blueteef/PTZ_controller/visual_reference/Screenshot 2026-04-22 175219.png

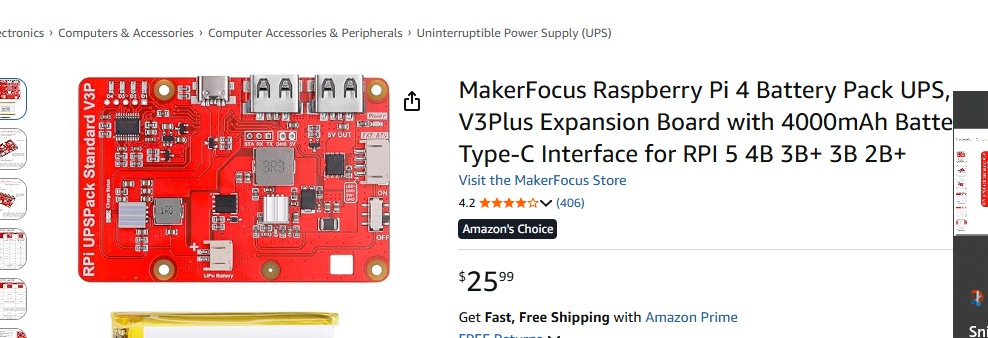
visual_reference/Screenshot 2026-04-22 175219.png
