blueteef/PTZ_controller/visual_reference/reference object.jpg

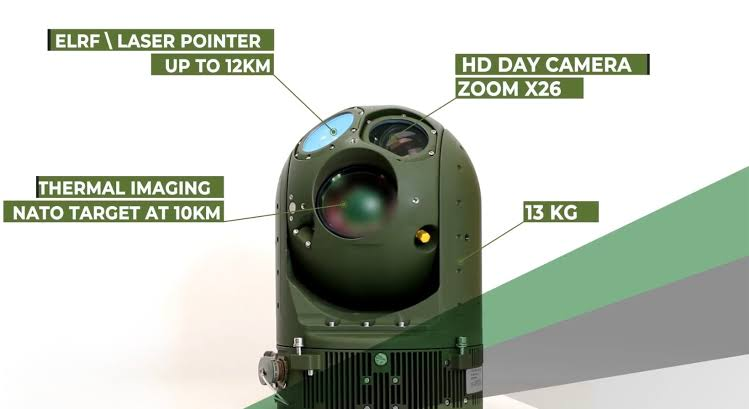
visual_reference/reference object.jpg
