blueteef/PTZ_controller/visual_reference/can_spi_mod_schematic.png

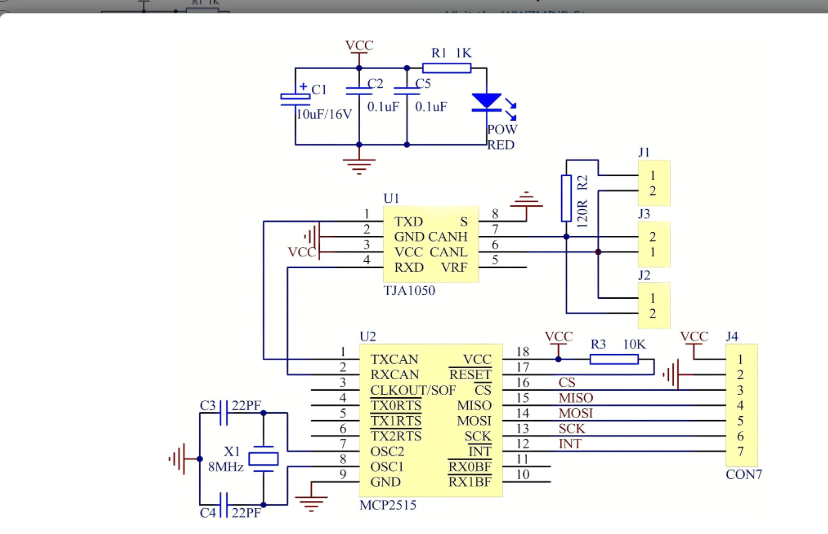
visual_reference/can_spi_mod_schematic.png
