blueteef/PTZ_controller/visual_reference/can_trans.png

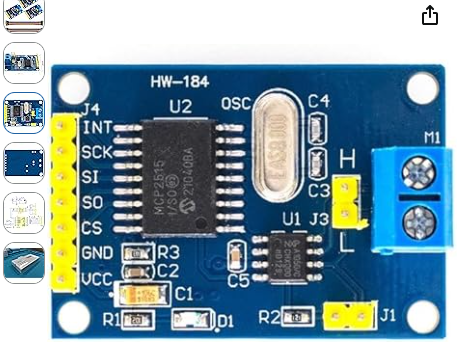
visual_reference/can_trans.png
