blueteef/PTZ_controller/visual_reference/full_schematic.jpg

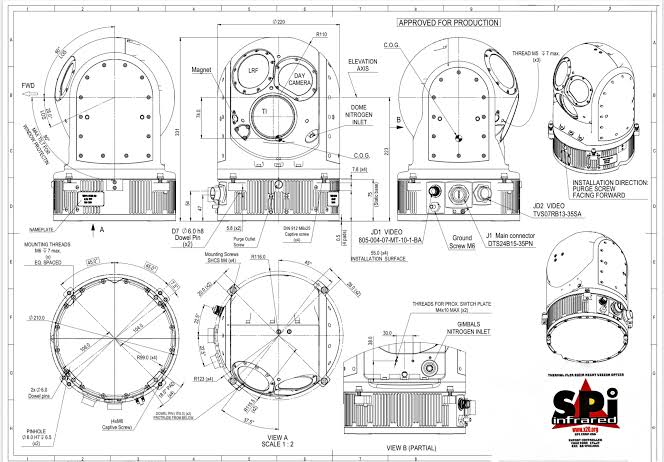
visual_reference/full_schematic.jpg
