blueteef/PTZ_controller/visual_reference/mcp_trans_actual.png

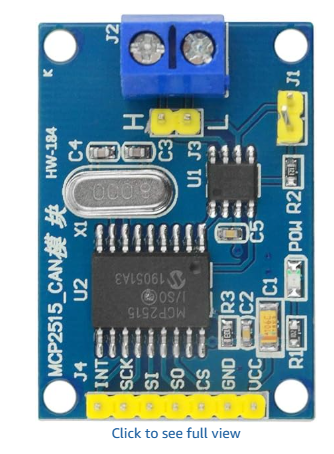
visual_reference/mcp_trans_actual.png
