blueteef/PTZ_controller/visual_reference/waveshare_can_1.png

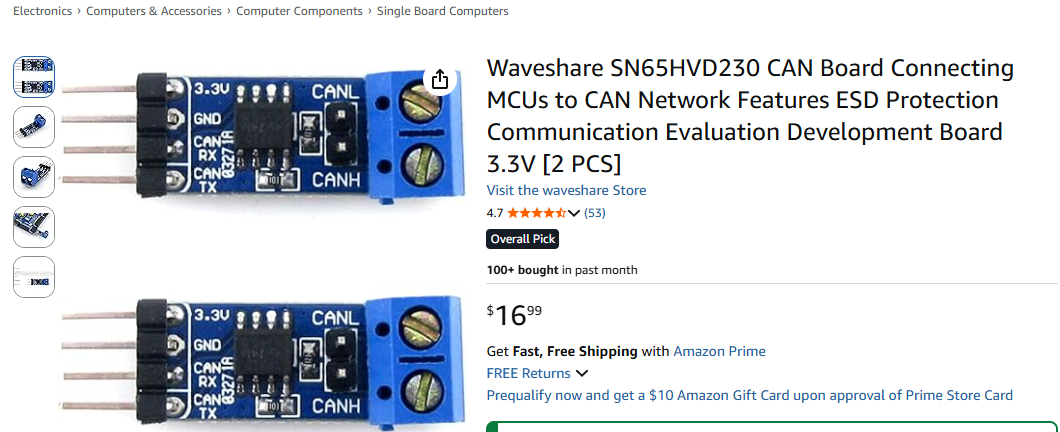
visual_reference/waveshare_can_1.png
