blueteef/PTZ_controller/Cbuild_log.txt

/usr/bin/bash: line 1: pio: command not found
