blueteef/PTZ_controller/KiCAD Models/EOIR_gimbal/EOIR_gimbal.kicad_pcb

## KiCad design main_controller/main_controller.kicad_sch

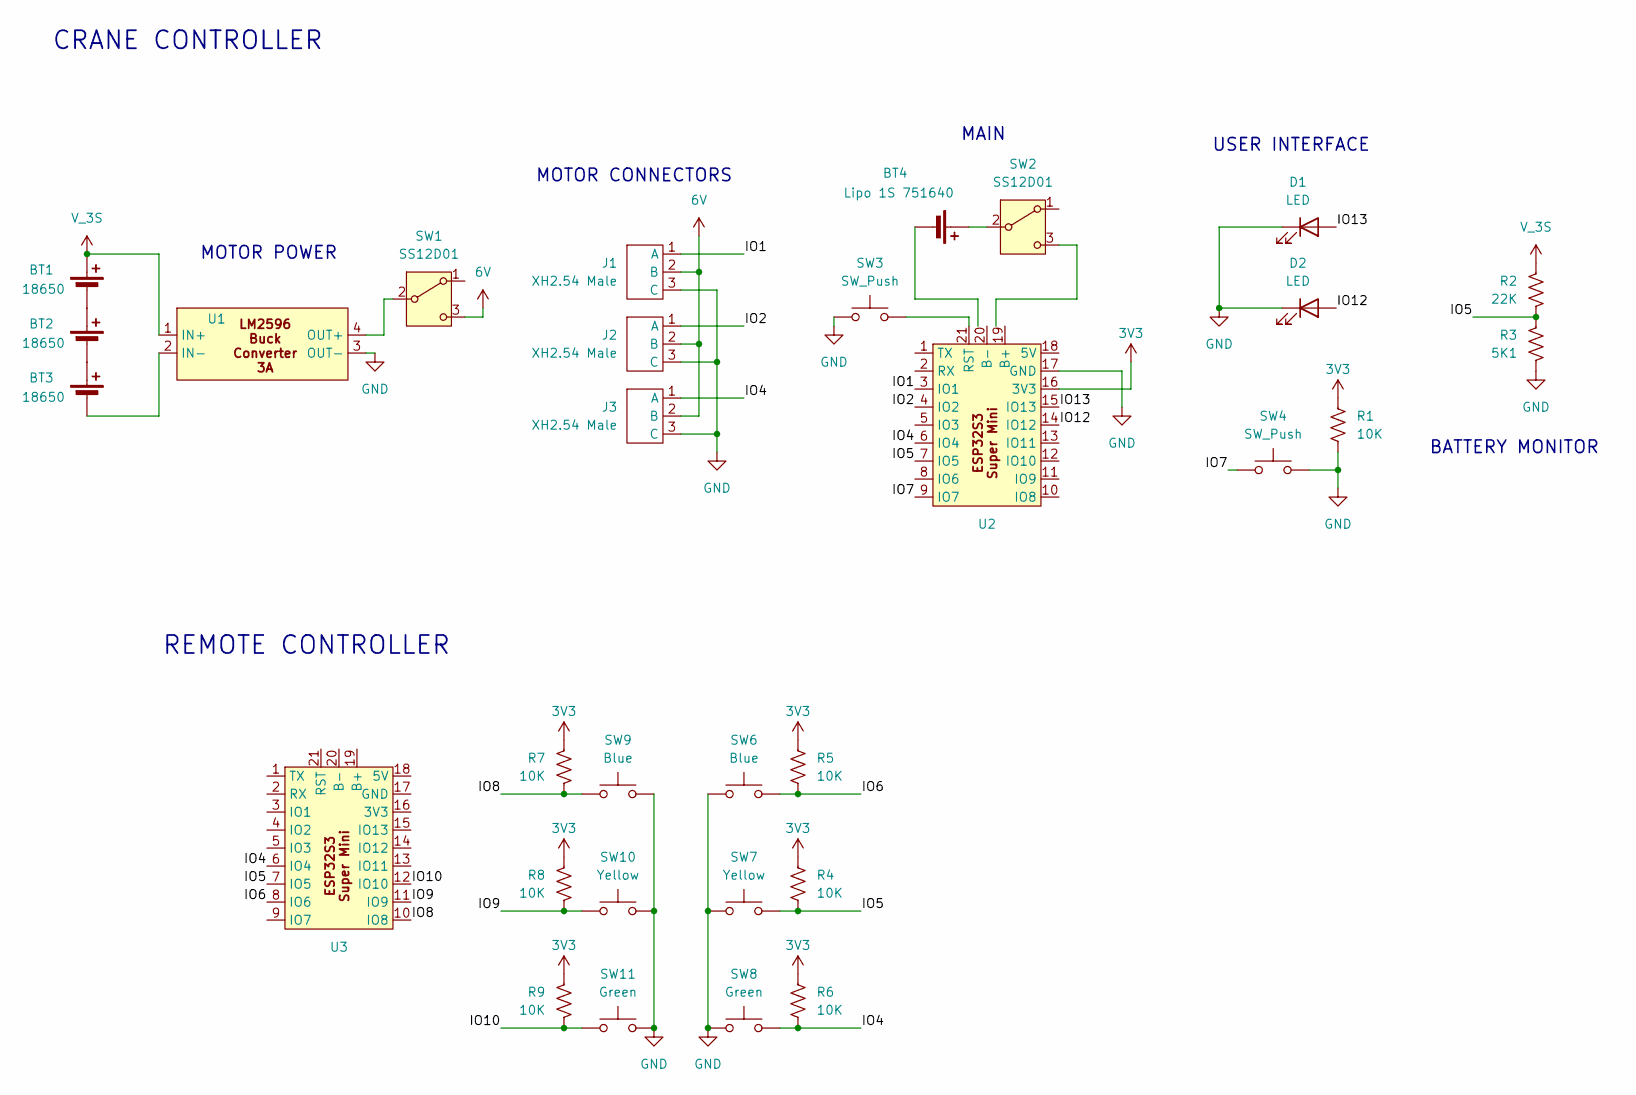
[picture p8: schematic main_controller.kicad_sch]

Parts:
BT1, BT2, BT3: 18650
BT4: Lipo 1S 751640
D1, D2: LED
J1, J2, J3: XH2.54 Male; XH_2p54_3P_male
R1, R4, R5, R6, R7, R8, R9: 10K
R2: 22K
R3: 5K1
SW1, SW2: SS12D01
SW3, SW4: SW_Push
SW6, SW9: Blue
SW7, SW10: Yellow
SW8, SW11: Green
U1: LM2596_Module
U2, U3: esp32s3_super_mini

Connections:
3V3: R1.1, R4.1, R5.1, R6.1, R7.1, R8.1, R9.1, U2.16 (3V3)
6V: J1.2 (B), J2.2 (B), J3.2 (B), SW1.3 (C)
GND: D1.1 (K), D2.1 (K), J1.3 (C), J2.3 (C), J3.3 (C), R1.2, R3.2, SW3.1, SW4.1, SW6.1, SW7.1, SW8.1, SW9.1, SW10.1, SW11.1, U1.3 (OUT-), U2.17 (GND)
IO1: J1.1 (A), U2.3 (IO1)
IO2: J2.1 (A), U2.4 (IO2)
IO4: J3.1 (A), R6.2, SW8.2, U2.6 (IO4), U3.6 (IO4)
IO5: R2.2, R3.1, R4.2, SW7.2, U2.7 (IO5), U3.7 (IO5)
IO6: R5.2, SW6.2, U3.8 (IO6)
IO7: SW4.2, U2.9 (IO7)
IO8: R7.2, SW9.2, U3.10 (IO8)
IO9: R8.2, SW10.2, U3.11 (IO9)
IO10: R9.2, SW11.2, U3.12 (IO10)
IO12: D2.2 (A), U2.14 (IO12)
IO13: D1.2 (A), U2.15 (IO13)
unnamed: BT1.2 (-), BT2.1 (+)
unnamed: BT2.2 (-), BT3.1 (+)
unnamed: BT3.2 (-), U1.2 (IN-)
unnamed: BT4.1 (+), SW2.2 (B)
unnamed: SW1.2 (B), U1.4 (OUT+)
unnamed: SW3.2, U2.21 (RST)
V_3S: BT1.1 (+), R2.1, U1.1 (IN+)

Notes on the sheet:
REMOTE CONTROLLER
CRANE CONTROLLER
MOTOR CONNECTORS
MAIN
BATTERY MONITOR
USER INTERFACE
MOTOR POWER
