blueteef/PTZ_controller/pi/app/main.py

"""
main.py — FastAPI application factory and lifespan.

Startup order:
  1. ESPBridge threads start (serial connection to ESP32)
  2. CameraCapture thread starts
  3. VisionPipeline thread starts
  4. GimbalTracker initialised (injected with bridge.send)
  5. FastAPI serves routes

Shutdown: threads stopped in reverse order.

Launch:
  cd pi/
  uvicorn app.main:app --host 0.0.0.0 --port 8000

For development (auto-reload, Pi not required):
  uvicorn app.main:app --reload
"""

from __future__ import annotations

import asyncio
import logging
import signal
import sys
from contextlib import asynccontextmanager
from pathlib import Path

from fastapi import FastAPI
from fastapi.staticfiles import StaticFiles

from app.serial_bridge.bridge import bridge
from app.can.bridge import start as can_start, stop as can_stop
from app.can.protocol import build_home_cmd, AXIS_ALL
from app.can.bridge import send as can_send
from app.imu.reader import imu_reader
from app.camera.capture import camera
from app.camera.thermal import thermal_camera
from app.camera.webcam import webcam
from app.ups.reader import ups_reader
from app.vision.pipeline import pipeline
import app.vision.tracker as tracker_module
from app.vision.tracker import GimbalTracker
from app.api import router_stream, router_control, router_detection, router_settings, router_faces
from app.api import router_thermal
from app.api import router_webcam
from app import db

logging.basicConfig(
    level=logging.INFO,
    format="%(asctime)s  %(levelname)-8s  %(name)s  %(message)s",
)
log = logging.getLogger(__name__)

# Ensure Ctrl+C and systemctl stop both work cleanly
signal.signal(signal.SIGINT,  lambda *_: sys.exit(0))
signal.signal(signal.SIGTERM, lambda *_: sys.exit(0))


@asynccontextmanager
async def lifespan(app: FastAPI):
    # ── Startup ────────────────────────────────────────────────────────
    log.info("PTZ Pi server starting up")

    db.init_db()
    bridge.start()
    can_start()
    imu_reader.start()
    camera.start()
    thermal_camera.start()
    webcam.start()
    ups_reader.start()
    pipeline.start()

    # Inject bridge into tracker
    tracker_module.tracker = GimbalTracker(send_fn=bridge.send)

    # Auto-home disabled — trigger manually via Home All button in sidebar
    # (motor PWM causes CAN noise; home only when system is confirmed stable)

    log.info("All subsystems started")
    yield

    # ── Shutdown ───────────────────────────────────────────────────────
    log.info("Shutting down")
    if tracker_module.tracker:
        tracker_module.tracker.stop()
    pipeline.stop()
    camera.stop()
    thermal_camera.stop()
    webcam.stop()
    ups_reader.stop()
    imu_reader.stop()
    can_stop()
    bridge.stop()
    log.info("Shutdown complete")


app = FastAPI(
    title="PTZ Controller",
    description="Raspberry Pi vision and control server for the PTZ gimbal",
    version="2.0.0",
    lifespan=lifespan,
)

# ── Routers ────────────────────────────────────────────────────────────────
app.include_router(router_stream.router)
app.include_router(router_control.router)
app.include_router(router_detection.router)
app.include_router(router_settings.router)
app.include_router(router_faces.router)
app.include_router(router_thermal.router)
app.include_router(router_webcam.router)

# ── Static files (frontend) ────────────────────────────────────────────────
_frontend = Path(__file__).parent / "frontend"
app.mount("/", StaticFiles(directory=str(_frontend), html=True), name="frontend")
