blueteef/PTZ_controller/pi/app/config.py

"""
config.py — All tuneable constants for the Pi application.

Values can be overridden via environment variables or a .env file.
Load order: defaults below → .env file → environment.
"""

import os
from pathlib import Path

# Load .env file if present (must happen before any os.getenv calls)
try:
    from dotenv import load_dotenv
    load_dotenv(Path(__file__).parent.parent / ".env", override=True)
except ImportError:
    pass


def _env_bool(key: str, default: str = "false") -> bool:
    """Read a boolean env var robustly — strips whitespace, case-insensitive."""
    return os.getenv(key, default).strip().lower() == "true"

# ---------------------------------------------------------------------------
# Paths
# ---------------------------------------------------------------------------
PI_DIR   = Path(__file__).parent.parent          # pi/
DATA_DIR = PI_DIR / "data"
MODEL_DIR = PI_DIR / "models"

DATA_DIR.mkdir(exist_ok=True)
MODEL_DIR.mkdir(exist_ok=True)

DB_PATH              = str(DATA_DIR / "faces.db")
MODEL_YOLO_PATH      = str(MODEL_DIR / "yolov8n.pt")
MODEL_OBJECT_PATH    = str(MODEL_DIR / "efficientdet_lite0_int8.tflite")

# ---------------------------------------------------------------------------
# ESP32 serial bridge (v1 / fallback)
# ---------------------------------------------------------------------------
SERIAL_PORT        = os.getenv("SERIAL_PORT", "/dev/serial0")
SERIAL_BAUD        = int(os.getenv("SERIAL_BAUD", "115200"))
SERIAL_TIMEOUT     = 0.1   # seconds — read timeout per call
SERIAL_RECONNECT_S = 2.0   # wait between reconnect attempts

# ---------------------------------------------------------------------------
# CAN bus (v2 hardware — python-can socketcan)
# ---------------------------------------------------------------------------
CAN_CHANNEL = os.getenv("CAN_CHANNEL", "can0")
CAN_BITRATE = int(os.getenv("CAN_BITRATE", "500000"))

# ---------------------------------------------------------------------------
# Camera
# ---------------------------------------------------------------------------
# CAMERA_BACKEND: "picamera2" = CSI camera via libcamera (IMX462, IMX708, etc.)
#                 "v4l2"      = USB webcam via OpenCV V4L2 (current setup)
#                 "auto"      = try picamera2 first, fall back to v4l2
CAMERA_BACKEND = os.getenv("CAMERA_BACKEND", "v4l2")
CAMERA_DEVICE  = os.getenv("CAMERA_DEVICE",  "/dev/video0")   # V4L2 only
CAMERA_NUM     = int(os.getenv("CAMERA_NUM", "0"))             # Picamera2 camera index

CAMERA_WIDTH   = int(os.getenv("CAMERA_WIDTH",  "1280"))
CAMERA_HEIGHT  = int(os.getenv("CAMERA_HEIGHT", "720"))
CAMERA_FPS     = int(os.getenv("CAMERA_FPS",    "30"))

# IMX708 (Arducam/Pi Camera Module 3) field of view.
# Full-sensor binned mode (~66°H x 41°V) — applies at all output resolutions.
# Tune empirically by pointing at a target at known angles.
CAMERA_FOV_H_DEG = 66.0   # horizontal degrees
CAMERA_FOV_V_DEG = 41.0   # vertical degrees

# Camera orientation correction — set based on physical mount.
# 0=none, 1=90°CW, 2=180°(upside-down), 3=90°CCW
CAMERA_ROTATION = int(os.getenv("CAMERA_ROTATION", "0"))

# Image quality tuning.
# Sharpness 0-16 (default 1.0): higher = crisper edges, helps detection.
# Contrast  0-32 (default 1.0): slight boost separates features.
# NoiseReductionMode: 0=off 1=fast 2=high-quality
# AwbMode: 0=auto 1=incandescent 2=tungsten 3=fluorescent 4=indoor 5=daylight 6=cloudy
# AeMeteringMode: 0=centre-weighted 1=spot 2=matrix
CAMERA_SHARPNESS          = float(os.getenv("CAMERA_SHARPNESS",    "1.5"))
CAMERA_CONTRAST           = float(os.getenv("CAMERA_CONTRAST",     "1.1"))
CAMERA_NOISE_REDUCTION    = int(os.getenv("CAMERA_NOISE_REDUCTION", "1"))
CAMERA_AWB_MODE           = int(os.getenv("CAMERA_AWB_MODE",        "0"))
CAMERA_AE_METERING_MODE   = int(os.getenv("CAMERA_AE_METERING_MODE","0"))

# Autofocus — IMX708 only (Camera Module 3 / Arducam 12MP AF).
# AfMode: 0=manual  1=auto (trigger on demand)  2=continuous
# AfSpeed: 0=normal  1=fast
# AfRange: 0=normal (0.1m–inf)  1=macro  2=full
CAMERA_AF_MODE  = int(os.getenv("CAMERA_AF_MODE",  "2"))   # continuous
CAMERA_AF_SPEED = int(os.getenv("CAMERA_AF_SPEED", "1"))   # fast
CAMERA_AF_RANGE = int(os.getenv("CAMERA_AF_RANGE", "0"))   # normal

# ---------------------------------------------------------------------------
# MJPEG stream
# ---------------------------------------------------------------------------
MJPEG_QUALITY      = int(os.getenv("MJPEG_QUALITY", "75"))
MJPEG_TARGET_FPS   = CAMERA_FPS   # stream pacing

# ---------------------------------------------------------------------------
# UPS (MakerFocus UPSPack V3P — UART stream + STA shutdown pin)
# ---------------------------------------------------------------------------
# Requires in /boot/firmware/config.txt:
#   enable_uart=1
#   dtoverlay=disable-bt
# UPS_PORT: serial device (default /dev/ttyAMA0), or "none" to disable
# UPS_STA_GPIO: BCM GPIO for the STA shutdown signal pin (default 4 = physical pin 7)
UPS_PORT     = os.getenv("UPS_PORT",     "/dev/ttyAMA0")
UPS_STA_GPIO = int(os.getenv("UPS_STA_GPIO", "4"))

# ---------------------------------------------------------------------------
# Webcam (secondary visible camera — USB UVC, not the TC001 thermal)
# ---------------------------------------------------------------------------
# WEBCAM_DEVICE: "auto" = scan /dev/video0–19, skip TC001 and Pi camera devices
#                "/dev/videoX" = use specific device
#                "none" = disable
WEBCAM_DEVICE  = os.getenv("WEBCAM_DEVICE",  "auto")
WEBCAM_WIDTH   = int(os.getenv("WEBCAM_WIDTH",  "1280"))
WEBCAM_HEIGHT  = int(os.getenv("WEBCAM_HEIGHT", "720"))
WEBCAM_FPS     = int(os.getenv("WEBCAM_FPS",    "30"))

# ---------------------------------------------------------------------------
# Thermal camera (Topdon TC002 or compatible UVC thermal imager)
# ---------------------------------------------------------------------------
# THERMAL_DEVICE: "auto" = scan /dev/video0–19 for the first working device,
#                 "/dev/videoX" = use a specific device,
#                 "none" = disable thermal camera entirely.
THERMAL_DEVICE   = os.getenv("THERMAL_DEVICE", "auto")
# THERMAL_COLORMAP: OpenCV colormap name (INFERNO, JET, HOT, RAINBOW, etc.)
THERMAL_COLORMAP = os.getenv("THERMAL_COLORMAP", "INFERNO")

# ---------------------------------------------------------------------------
# Vision / detection
# ---------------------------------------------------------------------------
YOLO_CONFIDENCE    = float(os.getenv("YOLO_CONFIDENCE", "0.45"))
FACE_MIN_CONFIDENCE  = float(os.getenv("FACE_MIN_CONFIDENCE", "0.4"))  # MediaPipe threshold
FACE_MODEL_SELECTION = int(os.getenv("FACE_MODEL_SELECTION", "1"))     # 0=short range (<2m), 1=full range

# Detection performance — reduce CPU load on Pi
# DET_SCALE:      resize frame before object detection (YOLO/EfficientDet).  0.5 = half res.
#                 Bounding boxes are automatically scaled back to full resolution.
# FACE_DET_SCALE: scale for face detection.  MediaPipe face detection is fast enough at full
#                 resolution and is much more accurate — keep at 1.0 unless CPU is overloaded.
# DET_SKIP:       only run detector every N frames; reuse previous boxes in between.
DET_SCALE      = float(os.getenv("DET_SCALE",      "0.5"))
FACE_DET_SCALE = float(os.getenv("FACE_DET_SCALE", "1.0"))
DET_SKIP       = int(os.getenv("DET_SKIP",         "2"))

# ---------------------------------------------------------------------------
# Face recognition
# ---------------------------------------------------------------------------
FACE_RECOGNITION_TOLERANCE = float(os.getenv("FACE_RECOGNITION_TOLERANCE", "0.5"))
FACE_ENROLL_FRAMES         = 5   # frames captured per enrollment session

# ---------------------------------------------------------------------------
# Motion settings — Pi is the single source of truth.
# These are pushed to the ESP32 on every connect via push_settings().
# Changing them here (or via .env) is the only place you need to edit.
# ---------------------------------------------------------------------------
MAX_SPEED_DEG_S     = float(os.getenv("MAX_SPEED_DEG_S",     "180.0"))  # slider hard cap
DEFAULT_SPEED_DEG_S = float(os.getenv("DEFAULT_SPEED_DEG_S",  "45.0"))   # slider start value
ACCEL_DEG_S2     = float(os.getenv("ACCEL_DEG_S2",    "120.0"))
FINE_SPEED_SCALE = float(os.getenv("FINE_SPEED_SCALE",  "0.2"))

# Axis direction invert — flips the DIR pin on the ESP32 A4988 driver.
# Set in .env: PAN_INVERT=true  or  TILT_INVERT=true
PAN_INVERT  = _env_bool("PAN_INVERT")
TILT_INVERT = _env_bool("TILT_INVERT")

# Soft limits (degrees at output shaft)
PAN_SOFT_LIMIT_MIN  = float(os.getenv("PAN_SOFT_LIMIT_MIN",  "-180.0"))
PAN_SOFT_LIMIT_MAX  = float(os.getenv("PAN_SOFT_LIMIT_MAX",   "180.0"))
TILT_SOFT_LIMIT_MIN = float(os.getenv("TILT_SOFT_LIMIT_MIN",  "-45.0"))
TILT_SOFT_LIMIT_MAX = float(os.getenv("TILT_SOFT_LIMIT_MAX",   "90.0"))
SOFT_LIMITS_ENABLED = _env_bool("SOFT_LIMITS_ENABLED")

# How long to hold stepper current after motors stop (ms). 0 = hold forever.
# A4988 has no current-reduction mode — releasing EN eliminates heat and whine.
STEPPER_HOLD_MS = int(os.getenv("STEPPER_HOLD_MS", "2000"))

# ---------------------------------------------------------------------------
# IMU / Compass orientation alignment
# Correct for physical sensor mounting without reflashing the ESP32.
# ---------------------------------------------------------------------------

# Sign correction: 1 = normal, -1 = flip axis
IMU_ROLL_SIGN  = float(os.getenv("IMU_ROLL_SIGN",  "1"))
IMU_PITCH_SIGN = float(os.getenv("IMU_PITCH_SIGN", "1"))

# Swap roll and pitch if sensor is mounted 90° rotated around Z
IMU_SWAP_ROLL_PITCH = _env_bool("IMU_SWAP_ROLL_PITCH", "false")

# Zero-point offset (degrees) — applied after sign/swap correction.
# Use to remove a constant bias when the camera is level.
# e.g. if pitch reads +90° when level: IMU_PITCH_OFFSET_DEG=-90
IMU_ROLL_OFFSET_DEG  = float(os.getenv("IMU_ROLL_OFFSET_DEG",  "0.0"))
IMU_PITCH_OFFSET_DEG = float(os.getenv("IMU_PITCH_OFFSET_DEG", "0.0"))

# Compass offset (degrees) — corrects for magnetic declination or physical mount offset.
# Add your local declination (positive = east) or physical rotation here.
MAG_HDG_OFFSET_DEG = float(os.getenv("MAG_HDG_OFFSET_DEG", "0.0"))

# Invert compass direction (true = flip N/S, useful if sensor mounted backwards)
MAG_HDG_INVERT = _env_bool("MAG_HDG_INVERT", "false")

# ---------------------------------------------------------------------------
# IMU — tilt end-effector MPU-6050 (Pi I2C bus, GPIO 2/3)
#
# This is the TILT-CENTRIC IMU — mounted at the camera/end-effector for fine
# camera stabilization and acceleration compensation.
#
# The VEHICLE/PLATFORM IMU is a separate MPU-6050 on the stationary ESP32
# I2C bus. It reports vehicle attitude to the CAN bus as MSG_SENSOR_IMU and
# is used to correct for gross platform motion. These two sensors serve
# independent roles and are read by different nodes.
# ---------------------------------------------------------------------------
IMU_I2C_BUS   = int(os.getenv("IMU_I2C_BUS",   "1"))     # i2c-1: GPIO 2/3
IMU_RATE_HZ   = int(os.getenv("IMU_RATE_HZ",   "50"))    # complementary filter rate
IMU_COMP_ALPHA = float(os.getenv("IMU_COMP_ALPHA", "0.95"))  # gyro/accel blend

# Apply tilt compensation to compass using IMU roll/pitch.
# Set false if compass is mounted on the pan axis (doesn't tilt with camera)
# or if the IMU and compass are on different axes.
MAG_TILT_COMPENSATE = _env_bool("MAG_TILT_COMPENSATE", "true")

# ---------------------------------------------------------------------------
# Tracking PID
# ---------------------------------------------------------------------------
PID_KP             = 2.0     # proportional gain  (error in degrees → deg/s)
PID_KI             = 0.01    # integral gain
PID_KD             = 0.05    # derivative gain
PID_MAX_VEL_DEG_S  = float(os.getenv("PID_MAX_VEL_DEG_S", "45.0"))  # tracking speed cap
TRACKING_DEADBAND_PX = 15    # pixel radius around center — no correction inside

# Coast mode: if no detection for this many frames, decay velocity to zero
TRACKING_COAST_FRAMES = 5

# ---------------------------------------------------------------------------
# Telemetry
# ---------------------------------------------------------------------------
TELEMETRY_INTERVAL_S = 0.1   # how often to push telemetry to WebSocket clients

# ---------------------------------------------------------------------------
# Web server
# ---------------------------------------------------------------------------
HOST = "0.0.0.0"
PORT = 8000

# ---------------------------------------------------------------------------
# Claude API (optional)
# ---------------------------------------------------------------------------
ANTHROPIC_API_KEY = os.getenv("ANTHROPIC_API_KEY", "")
CLAUDE_MODEL      = "claude-haiku-4-5-20251001"
