blueteef/PTZ_controller/src/sensors/SensorManager.cpp

// =============================================================================
// SensorManager.cpp
// =============================================================================

#include "SensorManager.h"
#include <Wire.h>
#include <SoftwareSerial.h>
#include <INA226_WE.h>
#include <Adafruit_BMP280.h>
#include <TinyGPSPlus.h>
#include <math.h>
#include "config.h"

// I2C0 — stationary side
static INA226_WE       _ina(INA226_I2C_ADDR);
static Adafruit_BMP280 _bmp;

// GPS on SoftwareSerial — HardwareSerial 1 reserved for TMC2209 UART
static TinyGPSPlus     _gps;
static SoftwareSerial  _gpsSerial;

// -----------------------------------------------------------------------------
// Public
// -----------------------------------------------------------------------------

bool SensorManager::begin() {
    // I2C bus 0 — shared by INA226 and BMP280
    Wire.begin(I2C0_SDA_PIN, I2C0_SCL_PIN);

    // INA226
    _inaOk = _ina.init();
    if (_inaOk) {
        _ina.setResistorRange(INA226_SHUNT_OHM, INA226_MAX_A);
        Serial.printf("[SENS] INA226 OK — shunt %.3f Ω, max %.1f A\r\n",
                      INA226_SHUNT_OHM, INA226_MAX_A);
    } else {
        Serial.println("[SENS] INA226 not found (check I2C wiring/address)");
    }
    _data.inaOk = _inaOk;

    // BMP280
    _bmpOk = _bmp.begin(BMP280_I2C_ADDR);
    if (_bmpOk) {
        // Normal mode: 2x temp / 16x pressure oversampling, 16x IIR filter, 500 ms standby
        _bmp.setSampling(Adafruit_BMP280::MODE_NORMAL,
                         Adafruit_BMP280::SAMPLING_X2,
                         Adafruit_BMP280::SAMPLING_X16,
                         Adafruit_BMP280::FILTER_X16,
                         Adafruit_BMP280::STANDBY_MS_500);
        Serial.printf("[SENS] BMP280 OK (0x%02X)\r\n", BMP280_I2C_ADDR);
    } else {
        Serial.println("[SENS] BMP280 not found (check SDO pin, try addr 0x77)");
    }
    _data.bmpOk = _bmpOk;

    // GPS on SoftwareSerial — HardwareSerial 1 (Serial1) is reserved for TMC2209 UART
    _gpsSerial.begin(GPS_BAUD_RATE, SWSERIAL_8N1, GPS_RX_PIN, GPS_TX_PIN);
    Serial.printf("[SENS] GPS SoftwareSerial started — GPIO%d RX, GPIO%d TX, %d baud\r\n",
                  GPS_RX_PIN, GPS_TX_PIN, GPS_BAUD_RATE);

    // QMC5883L — direct Wire register access (I2C0, stationary side)
    // IMU (MPU-6050) is now read directly by the Pi on its own I2C bus.
    Wire.beginTransmission(QMC5883L_I2C_ADDR);
    Wire.write(0x0B);  // SET/RESET period register — must be 0x01 per datasheet
    Wire.write(0x01);
    _magOk = (Wire.endTransmission() == 0);
    if (_magOk) {
        Wire.beginTransmission(QMC5883L_I2C_ADDR);
        Wire.write(0x09);  // Control Register 1
        Wire.write(0x1D);  // Continuous mode | 200 Hz | 8G range | 512 OSR
        Wire.endTransmission();
        Serial.printf("[SENS] QMC5883L OK (0x%02X)\r\n", QMC5883L_I2C_ADDR);
    } else {
        Serial.println("[SENS] QMC5883L not found (check I2C0 wiring)");
    }
    _data.magOk = _magOk;

    return true;
}

// -----------------------------------------------------------------------------
// Private — called from sensorTask
// -----------------------------------------------------------------------------

void SensorManager::_readINA() {
    if (!_inaOk) return;
    _ina.readAndClearFlags();   // required before reading — clears conversion-ready flag
    _data.busVoltageV = _ina.getBusVoltage_V();
    _data.currentMA   = _ina.getCurrent_mA();
    _data.powerMW     = _ina.getBusPower() * 1000.0f;  // getBusPower() returns W → mW
}

void SensorManager::_readBMP() {
    if (!_bmpOk) return;
    _data.tempC    = _bmp.readTemperature();
    _data.pressHPa = _bmp.readPressure() / 100.0f;
    _data.altM     = _bmp.readAltitude(1013.25f);  // standard sea-level reference
}

void SensorManager::_feedGPS() {
    while (_gpsSerial.available()) {
        _gps.encode(_gpsSerial.read());
    }
    _data.gpsFix  = _gps.location.isValid();
    _data.gpsSats = _gps.satellites.isValid() ? (uint8_t)_gps.satellites.value() : 0;
    if (_gps.location.isValid()) {
        _data.gpsLat = _gps.location.lat();
        _data.gpsLon = _gps.location.lng();
    }
    _data.gpsHdgDeg   = _gps.course.isValid() ? (float)_gps.course.deg()  : 0.0f;
    _data.gpsSpdKnots = _gps.speed.isValid()  ? (float)_gps.speed.knots() : 0.0f;
}

void SensorManager::_readMag() {
    if (!_magOk) return;
    Wire.beginTransmission(QMC5883L_I2C_ADDR);
    Wire.write(0x00);  // data registers start at 0x00
    if (Wire.endTransmission(false) != 0) return;
    Wire.requestFrom((uint8_t)QMC5883L_I2C_ADDR, (uint8_t)6);
    if (Wire.available() < 6) return;
    // Store raw counts — tilt compensation is done on the Pi using
    // corrected roll/pitch so the IMU axis orientation offsets are applied.
    _data.magRawX = (int16_t)(Wire.read() | (Wire.read() << 8));
    _data.magRawY = (int16_t)(Wire.read() | (Wire.read() << 8));
    _data.magRawZ = (int16_t)(Wire.read() | (Wire.read() << 8));
    _data.magOk   = true;
}

void SensorManager::_pushSlow() {
    Serial2.printf("$PWR ok=%d,vin=%.3f,curr=%.1f,pwr=%.1f\r\n",
                   _data.inaOk ? 1 : 0,
                   _data.busVoltageV, _data.currentMA, _data.powerMW);
    if (_data.bmpOk) {
        Serial2.printf("$ENV temp=%.2f,press=%.2f,alt=%.1f\r\n",
                       _data.tempC, _data.pressHPa, _data.altM);
    }
    Serial2.printf("$GPS lat=%.6f,lon=%.6f,fix=%d,sats=%d,hdg=%.1f,spd=%.2f\r\n",
                   _data.gpsLat, _data.gpsLon,
                   _data.gpsFix ? 1 : 0,
                   _data.gpsSats,
                   _data.gpsHdgDeg,
                   _data.gpsSpdKnots);
}

void SensorManager::_pushFast() {
    Serial2.printf("$MAG ok=%d,mx=%d,my=%d,mz=%d\r\n",
                   _data.magOk ? 1 : 0,
                   _data.magRawX, _data.magRawY, _data.magRawZ);
}

// -----------------------------------------------------------------------------
// FreeRTOS task
// -----------------------------------------------------------------------------

void SensorManager::sensorTask(void* param) {
    SensorManager* sm = static_cast<SensorManager*>(param);

    for (;;) {
        uint32_t now = millis();

        // Compass: read and push at 20 Hz
        if (now - sm->_lastImuPushMs >= SENSOR_IMU_PUSH_MS) {
            sm->_lastImuPushMs = now;
            sm->_readMag();
            sm->_pushFast();
        }

        // GPS feed: run every task tick for fast fix acquisition
        sm->_feedGPS();

        // Slow sensors: INA226 / BMP280 / GPS telemetry at 1 Hz
        if (now - sm->_lastSlowMs >= SENSOR_PUSH_MS) {
            sm->_lastSlowMs = now;
            sm->_readINA();
            sm->_readBMP();
            sm->_pushSlow();
        }

        vTaskDelay(pdMS_TO_TICKS(10));  // 100 Hz task rate, handles 20 Hz IMU timing
    }
}
