blueteef/PTZ_controller/src/sensors/SensorManager.h

#pragma once

// =============================================================================
// SensorManager — Stationary and moving-side sensor suite.
//
// Stationary (I2C0, GPIO22/23):
//   INA226   — 12 V bus voltage, current, power (0x40, R100 shunt)
//   BMP280   — temperature, pressure, altitude   (0x76, SDO=GND)
//   GPS      — lat/lon/heading/speed/fix/sats    (SoftwareSerial GPIO16/13)
//   QMC5883L — compass raw counts (0x0D) — pan axis mount, away from motors/RF
//
// IMU (MPU-6050) now read directly by the Pi (end-effector mount, Pi I2C).
//
// Push protocol (Serial2 → Pi, 1 Hz):
//   $PWR ok=1,vin=12.45,curr=823.0,pwr=10234.0
//   $ENV temp=23.4,press=1013.2,alt=45.3
//   $GPS lat=47.123456,lon=-122.567890,fix=1,sats=8,hdg=180.5,spd=0.00
//   $MAG ok=1,mx=1234,my=-567,mz=890
// =============================================================================

#include <Arduino.h>

struct SensorData {
    // INA226
    float busVoltageV = 0.0f;
    float currentMA   = 0.0f;
    float powerMW     = 0.0f;
    bool  inaOk       = false;

    // BMP280
    float tempC    = 0.0f;
    float pressHPa = 0.0f;
    float altM     = 0.0f;
    bool  bmpOk    = false;

    // GPS
    bool    gpsFix      = false;
    uint8_t gpsSats     = 0;
    double  gpsLat      = 0.0;
    double  gpsLon      = 0.0;
    float   gpsHdgDeg   = 0.0f;
    float   gpsSpdKnots = 0.0f;

    // QMC5883L compass (stationary/pan-axis) — raw counts; Pi does tilt compensation
    int16_t magRawX = 0;
    int16_t magRawY = 0;
    int16_t magRawZ = 0;
    bool    magOk   = false;
};

class SensorManager {
public:
    bool begin();

    SensorData getData() const { return _data; }

    static void sensorTask(void* param);

private:
    void _readINA();
    void _readBMP();
    void _feedGPS();
    void _readMag();
    void _pushSlow();   // INA / BMP / GPS  — 1 Hz
    void _pushFast();   // MAG              — 20 Hz

    SensorData _data;
    bool     _inaOk         = false;
    bool     _bmpOk         = false;
    bool     _magOk         = false;
    uint32_t _lastSlowMs    = 0;   // INA / BMP / GPS push timer (1 Hz)
    uint32_t _lastImuPushMs = 0;   // MAG push timer (20 Hz)
};
