blueteef/PTZ_controller/(commit log)

2026-03-23 Add Phase 2 Pi application, vel CLI command, and project docs
    - src/cli: add `vel <pan|tilt|all> <deg_s>` command for continuous
    velocity control from Pi tracking loop (no echo/response printed)
    - pi/: full Phase 2 application scaffold (Phases 2a-2e complete)
    - FastAPI server: MJPEG stream, WebSocket control, detection API
    - Serial bridge to ESP32 via existing CLI protocol
    - Vision pipeline: null/face/YOLO detectors, PID tracker
    - Dark web UI: virtual joystick, WASD keys, detection overlay
    - Camera rotation config (CAMERA_ROTATION=2 for inverted mount)
    - Fix: stop/estop buttons now kill joystick velocity interval
    - docs/data_hx.txt: full session history and Phase 2 roadmap
    - .g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
    [CLI.cpp, CLI.h, bridge.py, capture.py, config.py]
2026-03-23 Fix controls: toggle/lag/focus issues
    - keydown/keyup moved to window (survives canvas focus steal)
    - ignore e.repeat on keydown (was firing continuous keydown events)
    - window blur clears all keys and stops motion immediately
    - joystick pointerup on window (survives drag outside canvas bounds)
    - send one velocity frame immediately on input (removes 40ms delay)
2026-03-23 Wire tracker into vision pipeline
    - Call tracker.update() after every detection pass when tracking enabled
    - Setting detection mode to 'none' now auto-stops tracking
2026-03-23 Improve joystick feel, add axis inversion config
    - Add PAN_INVERT / TILT_INVERT flags to config.py (env var overrideable)
    - Add JOYSTICK_DEFAULT_SPEED (default 45 deg/s, was 180 — much more manageable)
    - Squared response curve on joystick: precise at low deflection, full speed at max
    - Expose /api/settings/ui endpoint so frontend reads defaults from server config
    - Apply inversion in router_control.py velocity handler
    To invert an axis, set in pi/.env:
    PAN_INVERT=true
    TILT_INVERT=true
    [config.py]
2026-03-23 Fix stop: zero velocity before stop command for MKS CR_UART mode
    MKS drivers in CR_UART mode hold last velocity until new command arrives.
    Send vel=0 on both axes before stop/estop to ensure motion halts even if
    stop command is delayed or the driver misses it.
2026-03-23 Switch to stepper drive mode: direction invert flags, dotenv fix
    ESP32:
    - Add PAN_DIR_INVERT / TILT_DIR_INVERT to config.h
    - Apply direction invert in MotionController::begin() via setDirectionPin()
    Pi:
    - Add python-dotenv to requirements.txt
    - Load .env file in config.py so PAN_INVERT etc. actually take effect
    Next step: change MKS drivers to CR_vFOC mode via OLED, wire Step/Dir/EN,
    flash env:esp32dev_stepper
    [MotionController.cpp, config.h, config.py]
2026-03-23 Update session history: end of day 2026-03-22
    - Document stepper mode switch as the immediate next task
    - Update hardware status to reflect what was actually tested
    - Note YOLO ARM incompatibility, dotenv fix, camera rotation
    - Clear next-step instructions at top of session history
2026-03-23 Switch to stepper drive mode (CR_vFOC)
    - Reassign Step/Dir/EN pins: Pan=32/33/25, Tilt=26/27/14
    - Fix PTZ_VERSION_EXTRA string define escaping in platformio.ini
    - Guard software homing motor start with PTZ_DRIVE_STEPPER ifdef
    [MotionController.cpp, config.h]
2026-03-23 Update session log — session 4 end of day
    Tilt MKS driver dead (FET blowout), waiting on replacement.
    Notes: GPIO input-only pins, accel fix needed, pin assignments final.
2026-03-23 Add A4988 per-axis driver support
    New build envs: esp32dev_a4988_tilt, esp32dev_a4988_both.
    Per-axis flags TILT_DRIVER_A4988 / PAN_DRIVER_A4988 skip MKS UART
    driver instantiation for that axis (_driver[idx] stays nullptr).
    Null-guard all _driver[] call sites outside existing #ifdef blocks.
    Also fixes latent emergencyStop() nullptr crash in stepper builds.
    [CLI.cpp, MotionController.cpp]
2026-03-24 Refactor: A4988 drivers, WASD jog control, Pi UART link rather than USB
2026-03-24 Refactor: A4988 drivers, WASD jog control, Pi UART link rather than USB, fix UART
    [config.py]
2026-03-24 UART bridge to esp32 fixed
    [CLI.cpp, CLI.h, bridge.py]
2026-03-24 UART bridge to esp32 fixed again...
    [bridge.py, config.h]
2026-03-24 UART bridge to esp32 fixed again.....
    [config.h, main.cpp]
2026-03-24 UART bridge to esp32 fixed again........
    [config.h, config.py]
2026-03-25 Replace ultralytics/torch with onnxruntime for YOLO; fix PID gains, tracking invert, bridge lock contention
    [config.py, export_yolo_onnx.py]
2026-03-25 fix .env file example
    [capture.py, config.h, config.py]
2026-03-28 Allow Pi server to start without a physical camera
    Wrap Picamera2 init/start in try/except so a missing or failed camera
    falls back to blank frames instead of crashing the server.
    [capture.py]
2026-03-28 Swap pan/tilt GPIO pin assignments to match physical wiring
    [config.h]
2026-03-28 Add Arducam/IMX708 Camera Module 3 support with continuous autofocus
    - Update FOV to 66°H x 41°V for IMX708
    - Add AfMode/AfSpeed/AfRange controls (continuous AF by default)
    - Reset default rotation to 0 (IMX219 needed 180° flip)
    - Update .env.example with autofocus options
    [capture.py, config.py]
2026-03-28 Fix test_serial.py default port to /dev/serial0
    [test_serial.py]
2026-03-28 Add UART diagnostic script with hex dump and loopback check
2026-03-28 Fix CLI: add missing ping command, fix get responses on Serial2
    - ping was never in the dispatch table — Pi got no response
    - get speed/accel/limits only printed to USB, not Serial2
    - All query responses now go to both USB and Pi UART
    [CLI.cpp, CLI.h]
2026-03-28 Lower Pi UART baud rate to 57600 for slip ring reliability
2026-03-28 Add Serial2 boot message for UART diagnostics
2026-03-29 Add facial recognition, enrollment, and name-based tracking
    - db/__init__.py: SQLite face database (enroll, list, delete encodings)
    - detector_face.py: dlib recognition pass every 5 frames; assigns name to Detection
    - router_faces.py: REST endpoints GET/POST enroll/DELETE faces
    - pipeline.py: set_recognition() toggle; passes flag to FaceDetector
    - tracker.py: name-based target priority over ID-based
    - router_control.py: set_tracking accepts target_name; new set_recognition message
    - state.py: tracking_target_name, recognition_enabled fields
    - main.py: init DB on startup, register face router
    - Frontend: recognition toggle, enroll panel, track-by-name dropdown, enrolled faces list
    Requires o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
2026-03-29 Fix WASD unresponsive after face enrollment
    - Blur active element after enrollment so keyboard focus returns to page
    - Run face_encodings in thread pool executor to avoid blocking event loop
2026-03-29 Fix WASD blocked by select focus; fix Ctrl+C swallowed by dlib
    - controls.js: only block WASD on text inputs, not SELECT elements
    - main.py: install SIGINT handler so Ctrl+C always terminates the process
    [main.py]
2026-03-29 Improve face enrollment: average multiple frames, better defaults
    - Enrollment now captures up to 5 frames over 2 seconds and averages
    encodings for a more robust sample
    - Show sample count in enrollment confirmation message
    - Add tip about enrolling from multiple angles
2026-03-29 Motion settings: Pi is single source of truth, remove ESP32 NVS
    - Remove all tunable defaults from config.h; ESP32 holds hardware constants only
    - Remove NVS load/save from MotionController; defaults are safe fallbacks until Pi connects
    - Add panDirInvert/tiltDirInvert to MotionSettings; applySettings() re-applies DIR pin on change
    - Add 'set invert <pan|tilt> <0|1>' CLI command; make 'save' a no-op with message
    - Pi config.py becomes authoritative for speed, accel, fine scale, invert, soft limits
    - bridge.py calls _push_settings() on every ESP32 connect (8 set commands)
    - protocol.py adds cmd_set_fine, cmd_set_invert, cmd_set_limits, cmd_set_limits_enabled
    - Remove Pi-side velocity sign-fli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
    [CLI.cpp, MotionController.cpp, MotionController.h, bridge.py, config.h, config.py, protocol.py]
2026-03-29 Fix stream FPS drop during detection: serve raw frame, draw boxes client-side
    The stream was serving annotated_frame (detection boxes composited by OpenCV),
    which only updates at detector speed — 2-5 fps for YOLO/MediaPipe on the Pi.
    This caused the MJPEG stream to appear to run at detector speed even though
    frames were being delivered at camera FPS.
    Fix: stream.py always serves current_frame (fresh from camera at full FPS).
    Detection boxes are drawn by the client-side canvas overlay via WebSocket
    detections, which was already in place. Server-side box drawing removed.
    Also fixes the double bounding-box issue: previously OpenCV drew boxes on the
    MJPEG stream AND the JS canvas drew them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
    [state.py, stream.py]
2026-03-29 Fix face detection box accuracy: run at full resolution (FACE_DET_SCALE=1.0)
    MediaPipe face detection is fast enough at 1280x720 on the Pi (~30-50ms vs
    ~400ms for EfficientDet). Running at DET_SCALE=0.5 (640x360) degraded accuracy
    because small relative-coordinate errors get doubled on scale-back, causing
    boxes to appear shifted significantly from the actual face.
    Add FACE_DET_SCALE config (default 1.0) separate from DET_SCALE (0.5 for YOLO).
    Pipeline selects the scale based on detector type. Override in .env if needed.
    [config.py]
2026-03-30 Fix blue camera feed: use BGR888 format, remove double color-space conversion
    Picamera2's capture_array() with "RGB888" format returns a BGR-ordered numpy
    array despite the misleading name. The code was then calling cvtColor(RGB2BGR)
    treating it as RGB, which re-swapped channels producing an RGB array. OpenCV's
    imencode() then treated that as BGR, swapping R and B channels in the JPEG.
    Result: reds appeared blue (classic channel-swap blue cast on warm subjects).
    Fix: request "BGR888" format explicitly — array is natively BGR, no cvtColor
    needed. This is the correct format name for OpenCV-compatible BGR output.
    [capture.py]
2026-03-30 Revert camera format change — RGB888 + cvtColor was correct
    [capture.py]
2026-03-30 Release stepper EN pins after 2s idle to reduce heat and coil whine
    A4988 has no current-reduction mode — it holds full rated current when enabled.
    After STEPPER_HOLD_MS (2000ms) of inactivity, the EN pin is pulled HIGH to
    de-energize the coils. On the next velocity or move command, EN is pulled LOW
    again before the motion command is issued.
    E-stop clear also resets hold state so enableAll() re-energizes both axes.
    STEPPER_HOLD_MS can be set to 0 in config.h to hold indefinitely.
    [MotionController.cpp, MotionController.h, config.h]
2026-03-30 Move stepper hold timeout to Pi config, push to ESP32 on connect
    Consistent with Pi-as-source-of-truth architecture. holdTimeoutMs added to
    MotionSettings (default 2000ms), set via 'set hold <ms>' CLI command.
    Pi pushes it in push_settings() alongside speed/accel/invert/limits.
    Override in .env: STEPPER_HOLD_MS=0 to hold indefinitely.
    [CLI.cpp, MotionController.cpp, MotionController.h, bridge.py, config.h, config.py, protocol.py]
2026-04-03 Add TMC2209 driver support (upgrade from A4988)
    - Add TMCStepper library dependency
    - TMCDriver configures both axes at boot over UART1 (GPIO4 TX / GPIO13 RX)
    - 700mA RMS current, StealthChop, 256x interpolation from 16x STEP input
    - Pan driver: UART address 0 (MS1=LOW, MS2=LOW on board)
    - Tilt driver: UART address 1 (MS1=HIGH, MS2=LOW on board)
    - STEP/DIR/EN pins and all FastAccelStepper motion logic unchanged
    - TMCDriver::begin() is non-fatal: logs warning if driver missing, motion still works
    - config.h: TMC UART pins, R_SENSE (0.11Ω BTT V1.3), current, addresses
    Wiring: GPIO4(TX) → 1kΩ → PDN_UART, GPIO13(RX) → PDN_UART directly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
    [TMCDriver.cpp, TMCDriver.h, config.h, main.cpp]
2026-04-03 Change TMC UART RX from GPIO13 to GPIO18, keep 16/17 free for GPS
2026-04-03 Change TMC UART RX to GPIO17
2026-04-04 Add INA226, BMP280, GPS sensor support (stationary side)
    - TMCDriver: switch from HardwareSerial(1) to SoftwareSerial, freeing
    Serial1 for GPS
    - config.h: add I2C0 pins, INA226/BMP280 addrs, GPS UART pins, sensor
    task constants
    - platformio.ini: add EspSoftwareSerial, INA226_WE, Adafruit BMP280,
    TinyGPSPlus libraries
    - SensorManager: new FreeRTOS task on core 0 reads INA226/BMP280 at
    1 Hz, feeds GPS at 20 Hz, pushes $PWR/$ENV/$GPS telemetry on Serial2
    - Pi bridge.py: drain and parse $-prefixed sensor lines from RX buffer
    during every poll cycle
    - Pi state.py: sensor_power/env/gps dicts on AppState
    - Pi schemas.py: sensor data included in telemetry WebSocket message
    - Pi router_cont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
2026-04-04 Fix choppy control; replace joystick with telemetry dashboard
    Control fix: revert _do_poll post-query readline loop from range(4)
    back to range(2). Extra iterations each blocked for SERIAL_TIMEOUT
    (0.1s), stalling the writer loop and delaying velocity commands.
    Dashboard: joystick canvas replaced with live telemetry panel showing
    gimbal position, power (V/mA/W), environment (temp/pressure/alt),
    and GPS (fix, coords, heading, speed). WASD/arrow keys still work.
    [bridge.py]
2026-04-04 Imperial units, always push $PWR with ok flag, GPS fix LED note
    - $PWR always pushed (ok=0 when INA226 not found) so dashboard shows
    ERR instead of blank when sensor init fails
    - All units converted to imperial: °F, inHg, ft, mph
    - GPS speed: knots → mph on Pi side
    [SensorManager.cpp, bridge.py]
2026-04-04 Fix INA226 bus voltage: call readAndClearFlags() before reading
    Required by INA226_WE library to latch conversion results before
    reading bus voltage and power registers. Also switch power to
    getBusPower() (uses INA226 internal power register, more accurate).
    [SensorManager.cpp]
2026-04-04 Add 'sensor' CLI command for manual INA226/BMP280/GPS readout
    Type 'sensor' in serial monitor to instantly print all sensor values.
    Useful for diagnosing INA226 bus voltage and GPS fix status without
    waiting for the Pi dashboard.
    [CLI.cpp, CLI.h, main.cpp]
2026-04-04 Revert TMC2209 to HardwareSerial(1), move GPS to SoftwareSerial
    SoftwareSerial at 115200 baud is unreliable for TMC2209 UART — causes
    driver comms failure. GPS at 9600 baud works fine on SoftwareSerial.
    Swapping the assignment restores TMC2209 operation.
    [SensorManager.cpp, TMCDriver.cpp]
2026-04-04 Fix .env bool parsing: override=True + strip() on comparisons
    load_dotenv without override=True silently ignores vars already set in
    the process environment. strip() handles CRLF line endings from Windows
    editors that would make 'true\r' != 'true'.
    [config.py]
2026-04-04 Fix service restart hang: SIGTERM handler + 10s stop timeout
    systemd sends SIGTERM on stop/restart; app only handled SIGINT.
    TimeoutStopSec=10 + KillMode=mixed force-kills after 10s if threads
    don't exit cleanly.
    [main.py]
2026-04-04 Fix service: username pi → snyder
2026-04-04 Add MPU-6050 IMU and QMC5883L compass; IMU/MAG at 20 Hz, slow sensors at 1 Hz
    - Wire1 on GPIO18(SDA)/GPIO5(SCL) for slip-ring side sensors
    - MPU-6050: roll/pitch from accelerometer (electroniccats library)
    - QMC5883L: tilt-compensated heading via direct Wire1 register access
    - IMU/MAG pushed at 20 Hz ($IMU, $MAG); INA/BMP/GPS stay at 1 Hz
    - Task rate increased to 100 Hz to support 20 Hz IMU timing
    - 'sensor' CLI command shows all six sensors
    - bridge.py: parse $IMU/$MAG lines
    - state.py: sensor_imu/sensor_mag fields
    - schemas.py + router: imu/mag in WebSocket telemetry
    - Dashboard: IMU roll/pitch and compass heading rows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
2026-04-04 Fix MPU-6050 I2C address: 0x98 (8-bit) → 0x4C (7-bit)
    [config.h]
2026-04-04 Revert MPU-6050 address back to 0x68 (AD0=GND)
    [config.h]
2026-04-04 IMU complementary filter, sensor orientation config, stabilization UI, calibration script
    - ESP32: complementary filter (alpha=0.98) for roll/pitch using gyro+accel;
    yaw blending for compass using gz + tilt-compensated mag heading
    - Pi: IMU_ROLL_SIGN, IMU_PITCH_SIGN, IMU_SWAP_ROLL_PITCH, MAG_HDG_OFFSET_DEG,
    MAG_HDG_INVERT .env vars — orientation corrections applied in bridge.py
    - Dashboard: roll/pitch/heading stabilization checkboxes wired to
    set_stabilization WS message; server state persisted for multi-client sync
    - scripts/calibrate_imu.py: interactive 5-step calibration helper — detects
    axis flips, swap, compass invert and offset; optionally writes to .env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
    [SensorManager.cpp, SensorManager.h, bridge.py, calibrate_imu.py, config.h, config.py, schemas.py]
2026-04-04 calibrate_imu: fix movement instructions for pan/tilt gimbal
    Roll check now says to physically tip the rig by hand (no roll motor).
    Pitch check says to use the TILT motor.
    Axis swap check references the TILT motor.
    Compass rotation check references the PAN motor.
    [calibrate_imu.py]
2026-04-04 calibrate_imu: live readings stay until user presses Enter
    Replace timed _watch() with _watch_until_enter() — display thread runs
    continuously in background while user makes the movement; Enter captures
    the result. No more racing against a countdown.
    [calibrate_imu.py]
2026-04-04 calibrate_imu: use tilt motor as ground truth; drop unreliable hand-tilt roll test
    Step 2 now auto-detects axis swap and pitch sign by watching which IMU axis
    moves when the tilt motor runs nose-down — no physical orientation knowledge
    needed. Roll sign step is now optional (tip/skip) with a clear explanation
    of why it can't be motor-tested on a pan/tilt rig. Total steps reduced 5→4.
    [calibrate_imu.py]
2026-04-04 Add HUD overlay, sidebar toggle, and IMU pitch offset/convergence fixes
    HUD overlay (detection_overlay.js):
    - Compass tape at top edge with scrolling azimuth tick marks, cardinal labels,
    heading bug and numeric readout
    - Artificial horizon: amber horizon line, pitch ladder, aircraft symbol
    - HUD checkbox in sidebar; auto-hides when detection mode is active
    - setDetectionMode() called from detection mode selector
    Sidebar:
    - Collapse/expand toggle button (◀/▶) in header status bar
    - Smooth CSS transition (width + opacity)
    IMU pitch fixes:
    - IMU_PITCH_OFFSET_DEG / IMU_ROLL_OFFSET_DEG .env vars — zero-point
    correction applied after sign/swap (e.g. +90° at level → set -90)
    - IMU_CO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
    [bridge.py, config.h, config.py]
2026-04-04 HUD: fix horizon pitch direction, add lock-roll option
    Pitch offset was inverted — nose down now correctly moves horizon up.
    Lock horizon vertical checkbox forces roll=0 in the horizon drawing
    so it stays upright regardless of IMU roll reading.
2026-04-04 Compass calibration UI — trim heading offset from the dashboard
    Input box + Set button in the Compass telemetry group. User points camera
    at a known bearing, types it in, clicks Set. Server computes the signed
    delta (shortest path), updates MAG_HDG_OFFSET_DEG in memory immediately,
    and writes the new value back to pi/.env for persistence across restarts.
    Confirmation echoed to browser console as compass_calibrated WS message.
2026-04-04 Full-screen HUD: move telemetry to overlay, hide sidebar at boot
    - detection_overlay.js rewritten: EMA-smoothed roll/pitch/heading, new
    updateTelemetryHUD() export, gimbal readout (top-left), power/GPS/env
    info strip (above compass tape), horizon pitch direction fixed, roll-lock
    support; HUD on by default
    - index.html: remove sidebar telemetry dashboard and axis-invert section;
    sidebar starts collapsed; stab checkboxes and compass cal moved to
    sidebar sections; hud-toggle pre-checked
    - app.js: import updateTelemetryHUD; remove wireInvertToggles; telemetry
    handler calls updateTelemetryHUD; _lastMagHdg tracks heading for cal
    pre-fill; sidebar toggle button initialised to ▶ at b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
2026-04-04 HUD: lock roll by default, 2x fonts, thicker horizon elements
    - _hudLockRoll defaults true (prevents rotated horizon from uncalibrated roll)
    - hud-lock-roll checkbox pre-checked in HTML to match
    - Gimbal readout: 13px → 26px, box sized accordingly
    - Info strip: 11px → 22px, background rect scaled
    - Pitch ladder labels: 10px → 20px, line lengths and widths doubled
    - Horizon line: lineWidth 2 → 4, gap widened for larger aircraft symbol
    - Aircraft symbol: lineWidth 2.5 → 5, wings scaled up proportionally
2026-04-04 HUD horizon: remove aircraft reticule, boost pitch ladder opacity
    - Aircraft symbol (blue wings + center dot) removed
    - Pitch ladder major lines: opacity 0.35 → 0.80, labels 0.5 → 0.85
    - Pitch ladder minor lines: opacity 0.35 → 0.50
2026-04-04 HUD horizon: rewrite without canvas transforms
    Replace save/translate/rotate/restore with explicit coordinate rotation
    using a pt(dx,dy) helper. Eliminates any transform-stack corruption
    from prior draw calls. Roll, pitch ladder, and horizon line all computed
    directly in canvas space.
2026-04-05 HUD: clamp pitchOffset to keep horizon on-screen
    Raw uncalibrated IMU pitch of ~+90° pushes pitchOff = h, sliding the
    entire horizon off the bottom of the canvas after first telemetry arrives.
    Clamp to ±(cy-20) so it stays visible regardless of calibration state.
2026-04-05 HUD horizon: fix pitch direction, restore ladder line weights
    - Negate pitchOff so nose-down raises the horizon line
    - Pitch ladder lineWidth: 3/2 → 1.5/1 (original weights)
    - Pitch ladder opacity: 0.80/0.50 → 0.45/0.25, labels 0.85 → 0.50
2026-04-05 HUD: increase EMA alphas for faster pitch/roll/heading response
    Previous alphas (0.2/0.12) took 10+ telemetry frames to converge,
    causing 2-3s lag and apparent overshoot. New values (0.6/0.4) reach
    ~94% of target within 2 frames (~1s at 500ms telemetry interval).
2026-04-05 Move compass tilt compensation from ESP32 to Pi
    ESP32 was applying tilt comp using its own raw (uncorrected) roll/pitch,
    which are offset ~90° due to the Y-axis-up IMU mount. This made heading
    wildly incorrect when tilted.
    ESP32 now sends raw QMC5883L counts (mx/my/mz) in $MAG.
    Pi bridge.py receives raw counts and applies tilt compensation using the
    already-corrected roll/pitch from state.sensor_imu, then applies the
    existing heading offset/invert. Flat assumption (mxc=mx, myc=my) used
    if IMU data is not yet available.
    [CLI.cpp, SensorManager.cpp, SensorManager.h, bridge.py]
2026-04-05 Add MAG_TILT_COMPENSATE flag, fix .env.example doc bug
    - MAG_TILT_COMPENSATE (default true): set false when compass is on pan
    axis and doesn't tilt with camera — skips roll/pitch correction
    - bridge.py: gate tilt comp on config.MAG_TILT_COMPENSATE
    - .env.example: add MAG_TILT_COMPENSATE entry; fix wrong var name
    JOYSTICK_DEFAULT_SPEED → MAX_SPEED_DEG_S
    [bridge.py, config.py]
2026-04-05 Move QMC5883L compass from I2C1 (moving) to I2C0 (stationary)
    Compass is now mounted on the pan axis away from the tilt motor and
    WiFi antenna. All Wire1 references in QMC5883L init and _readMag()
    changed to Wire. MPU-6050 remains on Wire1 through the slip ring.
2026-04-05 calibrate_imu.py: fix MAG format, add level offsets, fix axis detection
    - Parse new $MAG mx/my/mz format; compute heading via atan2(-my, mx)
    - Write IMU_ROLL_OFFSET_DEG + IMU_PITCH_OFFSET_DEG (were never written
    before — caused the persistent +90° level offset)
    - Step 2: ask user which direction tilt moved (down/up) instead of
    assuming nose-down, making it work in any mounting orientation
    - Step 3: new level offset step — levels corrected roll/pitch to 0
    after sign/swap are determined; live display shows corrected values
    - Apply corrections incrementally so live display reflects current state
    - Baud default updated to 115200 to match app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
    [calibrate_imu.py]
2026-04-05 HUD: remove pitch negation now that IMU calibration sets correct sign
    Calibration script now writes IMU_PITCH_SIGN so nose-down = negative
    pitch. The previous negation was a workaround for the uncalibrated
    sensor and was double-negating.
2026-04-05 calibrate_imu.py: fix sign written to wrong variable when axes swapped
    When IMU_SWAP_ROLL_PITCH=true, bridge.py computes display_pitch from
    roll_raw * IMU_ROLL_SIGN. The old code wrote the direction fix to
    IMU_PITCH_SIGN which has no effect on the pitch axis after swap.
    Now correctly writes to IMU_ROLL_SIGN when swapped, IMU_PITCH_SIGN
    when not swapped.
    [calibrate_imu.py]
2026-04-05 Compass: two-layer EMI spike rejection for tilt motor interference
    Pi side (bridge.py):
    - Track pan position changes; freeze compass reading if heading jumps
    >20° and pan hasn't moved in the last 400ms — tilt motor EMI hits
    the compass but pan shouldn't change heading during tilt-only motion
    JS side (detection_overlay.js):
    - _emaAngle: reduce alpha to 3% for jumps >25° so display barely moves
    on interference spikes, then converges quickly when movement stops
    [bridge.py]
2026-04-05 Revert compass EMI filtering — caused worse bouncing
    Pi-side freeze created discontinuities due to unreliable pan-movement
    detection at 20Hz. JS spike rejection threshold too tight, prevented
    convergence when hard-iron offset pushed readings past 25°.
    Back to clean EMA. HDG_ALPHA reduced 0.4 → 0.15 for smoother display;
    residual motor interference is a hardware proximity issue.
    [bridge.py]
2026-04-06 Move IMU from ESP32 I2C1 to Pi I2C — end-effector mount
    Pi is mounted on the end effector and moves with the camera in all axes,
    so its I2C bus is the natural place to read the MPU-6050. Eliminates
    IMU wires through the slip ring entirely.
    Pi side:
    - app/imu/reader.py: MPU-6050 reader via smbus2, complementary filter
    at 50 Hz, orientation corrections applied here (was in bridge.py)
    - app/main.py: start/stop imu_reader in lifespan
    - app/config.py: add IMU_I2C_BUS, IMU_RATE_HZ, IMU_COMP_ALPHA
    - serial_bridge/bridge.py: remove $IMU parsing (no longer sent)
    - requirements.txt: add smbus2
    ESP32 side:
    - Remove MPU6050 library, _mpu object, Wire1 init, _readIMU()
    - Remove $IMU serial push fro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
    [CLI.cpp, SensorManager.cpp, SensorManager.h, bridge.py, config.py, main.py, reader.py]
2026-04-11 Thermal camera: add Topdon TC002 viewer as GUI picture-in-picture
    - pi/app/camera/thermal.py: ThermalCamera singleton; background thread
    captures from TC002 via OpenCV V4L2 with auto device discovery.
    Handles Y16 raw (normalize + colormap) and pseudo-color YUYV/MJPEG.
    Auto-reconnects on read failure.
    - pi/app/api/router_thermal.py: /thermal/stream MJPEG + /thermal/status JSON
    - config.py: THERMAL_DEVICE (default auto) and THERMAL_COLORMAP (INFERNO)
    - main.py: thermal_camera lifecycle + router registered
    - Frontend: PIP overlay in video panel, "Thermal: Off/ON" toggle in mode-bar
    [config.py, main.py, thermal.py]
2026-04-11 thermal: fix auto-detect clobbering Pi camera feed
    _probe() was opening /dev/video0 (Pi camera V4L2 compat device),
    competing with Picamera2 and corrupting the main stream.
    Add _is_usb_video_device() which reads the V4L2 card name from sysfs
    before touching the device. Any device whose name contains unicam,
    bcm2835, rpi, isp, imx708, or ov5647 is skipped. USB UVC devices
    (TC002) are unaffected.
    [thermal.py]
2026-04-12 Add KiCAD schematics and visual reference; update .gitignore
    KiCAD Models/EOIR_gimbal: full schematic set (root, pan_centric,
    tilt_centric, stationary_side, symbol libraries, project files).
    visual_reference: mechanical drawing and reference EOIR turret image.
    .gitignore: exclude KiCAD transient files (#auto_saved_files#,
    *.lck, fp-info-cache, *-backups/).
    [EOIR_gimbal.kicad_pcb, EOIR_gimbal.kicad_sch, pan_centric.kicad_sch, stationary_side.kicad_sch, tilt_centric.kicad_sch]
2026-04-14 KiCAD: update schematics — TMC2209 pinout, GPS, lens controller wiring
    [pan_centric.kicad_sch, stationary_side.kicad_sch, tilt_centric.kicad_sch]
2026-04-16 v2 repo restructure: CAN bus multi-node architecture
    - Archive v1 firmware to archive/v1_firmware/
    - Add nodes/pan, nodes/tilt, nodes/stationary with stub main.cpp + config.h
    - Add protocol/can_ids.h and can_frames.h (shared CAN protocol definitions)
    - Add pi/app/can/ (bridge.py + protocol.py) — replaces serial_bridge for v2 hardware
    - Rewrite platformio.ini with three environments (pan, tilt, stationary)
    - Add python-can to pi/requirements.txt
    [CLI.cpp, CLI.h, MotionController.cpp, MotionController.h, SensorManager.cpp, SensorManager.h, StatusLED.cpp, StatusLED.h]
2026-04-16 stationary: switch to ESP32 DevKit, assign all GPIO pins; add CAN config to Pi
    nodes/stationary/include/config.h: full pin assignments for ESP32 DevKit —
    TMC2209 (STEP/DIR/EN + UART2), VSPI encoder (CS=15), I2C bus (SDA=21/SCL=22),
    GPS UART1 (RX=13/TX=12), TWAI CAN (TX=5/RX=4). I2C addresses documented.
    pi/app/config.py: add CAN_CHANNEL and CAN_BITRATE constants (socketcan can0,
    500 kbps default) referenced by app/can/bridge.py.
2026-04-16 docs: clarify dual-MPU architecture across stationary and tilt nodes
    Two MPU-6050s serve independent roles:
    - Stationary ESP32 I2C: vehicle/platform IMU — coarse stabilization against
    platform motion; reports to CAN as MSG_SENSOR_IMU.
    - Pi I2C (tilt end-effector): fine camera stabilization and acceleration
    compensation; read directly by Pi, not on CAN bus.
    Updated comments in stationary/config.h, pi/app/config.py, and
    pi/app/can/protocol.py to make the distinction explicit.
2026-04-21 fix: thermal camera probe fails on TC001 (YUYV 256x192 only)
    TC001 only supports YUYV at 256x192 — OpenCV's default probe attempts
    640x480 which the device rejects, causing probe to return no frames.
    Set resolution explicitly in both _probe() and _open(), and remove the
    Y16 FOURCC request (TC001 does not support raw 16-bit output).
    [thermal.py]
2026-04-21 fix: use integer device index for OpenCV V4L2 capture on Pi
    OpenCV's CAP_V4L2 backend on this Pi build cannot open devices by string
    path (/dev/videoN) — must use integer index N instead. Convert path to
    index in both _probe() and _open(). Also makes _probe() an instance method
    to access _path_to_index().
    [thermal.py]
2026-04-21 feat: thermal camera 3-state toggle (Off / PIP / Main)
    Button cycles: Off → Thermal PIP → Thermal Main → Off.
    In Main mode: thermal stream fills the primary feed, Pi cam moves to
    the PIP corner labeled "VISIBLE", detection overlay hidden (boxes
    don't map to thermal geometry). Clicking the PIP steps back one state.
2026-04-21 fix: scale thermal feed to fill main view in main mode
    #feed was using max-width/max-height which won't upscale a 256x192
    thermal image. Switch to width/height 100% + object-fit:contain so
    small-resolution sources scale up to fill the panel.
2026-04-21 feat: thermal camera settings — colormap, brightness, contrast
    thermal.py: ThermalSettings dataclass; _apply_settings() converts to
    grayscale and re-applies chosen OpenCV colormap, then adjusts
    brightness/contrast via convertScaleAbs. Settings are thread-safe via
    a dedicated lock; applied per-frame in the capture loop.
    router_thermal.py: GET /thermal/status now returns current settings and
    available colormaps. PUT /thermal/settings accepts colormap/brightness/
    contrast with validation.
    Frontend: Thermal Camera section in sidebar (hidden until thermal is
    detected). Colormap dropdown auto-populated from API, brightness slider
    (-100 to +100), contrast slider (0.5x to 3.0x). Changes pushed w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
2026-04-21 fix: thermal settings section hidden when JS error occurs before display toggle
    section.style.display was set at the bottom of wireThermalSettings —
    any error earlier in the function kept the section hidden. Move it to
    the top, add null guards on settings/colormaps, and surface fetch
    errors to console instead of silently swallowing them.
2026-04-21 feat: dual camera backend (picamera2/v4l2) + thermal device discrimination
    capture.py: CAMERA_BACKEND config selects picamera2 (CSI/IMX462) or
    v4l2 (USB webcam). Default is now v4l2 with CAMERA_DEVICE=/dev/video0.
    auto mode tries picamera2 first then falls back. Switch via .env when
    IMX462 is connected: CAMERA_BACKEND=picamera2.
    thermal.py: probe now verifies device actually accepted 256x192 before
    treating it as thermal. Webcams negotiate a different resolution and are
    skipped, so TC001 is found reliably even with a webcam on video0.
    config.py: add CAMERA_BACKEND and CAMERA_DEVICE settings.
    [capture.py, config.py, thermal.py]
2026-04-21 fix: request MJPEG fourcc for V4L2 USB webcam capture
    USB webcams deliver 30fps at high resolutions only in MJPEG mode.
    YUYV at 1280x720 is limited to ~10fps on this webcam. Explicitly
    set CAP_PROP_FOURCC to MJPG before configuring resolution and FPS.
    [capture.py]
2026-04-21 feat: Picamera2 camera index selection + graceful AF control handling
    config.py: add CAMERA_NUM (default 0) to select Picamera2 camera by
    index. IMX462 enumerates at index 0, USB cameras at 1 and 2.
    capture.py: pass CAMERA_NUM to Picamera2(); check camera_controls
    before setting AF controls — IMX462 has no autofocus so AfMode/AfSpeed/
    AfRange are skipped. Log camera model name on startup.
    Switch to IMX462 via .env: CAMERA_BACKEND=picamera2
    [capture.py, config.py]
2026-04-21 feat: USB webcam stream with 3-state PIP/main toggle
    - WebcamCapture: auto-discovers USB V4L2 device, skips TC001 (256x192
    fingerprint) and Pi camera kernel devices; MJPEG at config resolution
    - /webcam/stream MJPEG endpoint and /webcam/status JSON
    - config: WEBCAM_DEVICE/WIDTH/HEIGHT/FPS env vars
    - Frontend: Webcam button in mode bar (Off → PIP → Main), bottom-left
    PIP overlay, pip-click steps back; disabled if not detected
    - main.py: webcam lifecycle wired into startup/shutdown
    [config.py, main.py, webcam.py]
2026-04-21 feat: CAN bus setup — MCP2515 wiring, config.txt overlay, systemd-networkd
    - setup.sh: install can-utils, append mcp2515-can0 dtoverlay if absent,
    create /etc/systemd/network/can0.network for auto-bringup at 500k
    - .env.example: document CAN_CHANNEL and CAN_BITRATE
2026-04-22 feat: thermal fan controller — GPIO17, hardened daemon + fan-ctl CLI
    - fan_control.py: gpiozero-based daemon, high-active GPIO17
    - Fan ON at startup before first temp read (safe state)
    - Hysteresis: on at 65°C, off at 55°C (FAN_ON/OFF_TEMP env vars)
    - Fail-safe: fan ON if temp reads fail 3 times consecutively
    - SIGTERM/SIGINT handler sets fan ON before exit (daemon crash = fan on)
    - File-based override: /run/fan_override = on|off|auto
    - fan-ctl: CLI for manual override and status (temp, GPIO state, journalctl)
    - setup.sh: installs fan-control.service (auto-start on boot), fan-ctl to /usr/local/bin
    [fan_control.py]
2026-04-22 fix: move fan GPIO from 17 to 18 — GPIO17 is reserved for main power relay
    [fan_control.py]
2026-04-23 docs: Pi GPIO pinout reference — CAN, I2C, relay, fan, UPS
2026-04-23 feat: UPS battery monitor — UART reader, telemetry, shutdown, UI badge
    - ups/reader.py: parses MakerFocus V3P ASCII stream at 9600 8N1
    - Regex extracts pct/vout_mv/vin_ok/version from $ SmartUPS ... $ frame
    - STA pin (GPIO4) FALLING edge triggers graceful shutdown after 10s
    - Reconnects on serial error with backoff
    - state/schemas: sensor_ups field flows through to WebSocket telemetry as 'ups'
    - config: UPS_PORT=/dev/ttyAMA0, UPS_STA_GPIO=4
    - main: ups_reader lifecycle wired into startup/shutdown
    - frontend: battery badge in header (green/amber/red by %), emoji for charge state
    - docs: pinout updated — UART pins 8/10 and STA pin 7 now marked assigned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
    [config.py, main.py, reader.py, schemas.py, state.py]
2026-04-23 feat: serial bridge SERIAL_PORT=none skips UART — CAN bus mode
    [bridge.py]
2026-04-23 feat: CAN protocol + bridge — full message map, handlers, heartbeat
    - protocol.py: updated node/message IDs, all frame builders, all
    telemetry parsers writing to correct state fields (pos, imu, mag,
    gps, power, env, fault), centidegree integer encoding throughout
    - bridge.py: RX loop + 1Hz heartbeat thread, module-level singleton,
    serial_connected driven by incoming traffic and fault frames
    - main.py: can_start/can_stop wired into lifespan
    [bridge.py, main.py, protocol.py]
2026-04-23 feat: stationary node firmware — CAN, pan motor, sensors, GPS
    - protocol/can_ids.h + can_frames.h: updated to match Pi protocol.py
    (8-bit msg types, NODE_PI=7, MSG_STOP/HOME/SETTINGS/MAG/GPS2/FAULT)
    - nodes/stationary/src/main.cpp: TWAI RX/TX, Pi heartbeat watchdog,
    scheduled telemetry (pos 20Hz, IMU 50Hz, mag 5Hz, env/GPS/HB 1Hz)
    - nodes/stationary/src/motion.cpp: TMC2209 + FastAccelStepper + MT6816
    encoder, velocity + position mode, home command
    - nodes/stationary/src/sensors.cpp: MPU-6050 complementary filter,
    HMC5883L compass, BMP280 baro, INA226 power monitor (all raw I2C
    except BMP280/INA226 which use Adafruit/INA226_WE)
    - platformio.ini: stationary lib_deps added
    Co-Autho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
2026-04-23 feat: stationary node — BTS7960 brushed DC motor, direct-axis encoder
    - config.h: replace TMC2209/stepper pins with BTS7960 (RPWM/LPWM/REN/LEN)
    - motion.cpp: rewrite for brushed DC — velocity PID + position PID,
    LEDC PWM on channels 0/1 at 10kHz, brake via REN/LEN disable,
    MT6816 encoder direct on output shaft (no gear ratio in position math)
    - platformio.ini: clean up lib_deps per node — stationary no longer
    pulls stepper libs, default_envs = stationary
    [config.h, motion.cpp]
2026-04-23 fix: INA226_WE install via git URL — registry entry not found
2026-04-23 fix: BUILD_NODE_* flags to avoid clash with NODE_* ID constants; fix PID aggregate init
    [motion.cpp]
2026-04-23 feat: relay control on stationary node GPIO25 — MSG_RELAY_CMD over CAN
2026-04-23 revert: remove relay from stationary node — relay is Pi GPIO17 direct only
    [config.h, main.cpp, protocol.py]
2026-04-23 fix: QMC5883L (0x0D) driver replacing HMC5883L — clone chip confirmed by I2C scan
    [main.cpp, sensors.cpp]
2026-04-23 fix: CAN TX/RX moved to GPIO25/32 — GPIO5 strapping pin caused bus-off; remove debug logging
    [config.h, main.cpp]
2026-04-23 feat: encoder presence check on init — faults motor if encoder not detected
2026-04-23 feat: GPS configured to 115200 baud / 10Hz via PCAS commands on init
2026-04-23 fix: convert raw metric telemetry to display units in HUD (temp_f, press_inhg, alt_ft, spd_mph, power.ok)
2026-04-23 docs: add CAN module reference images and motor spec
2026-04-27 feat: hall sensor GPIO33 + encoder gear ratio — pinion-mounted MT6816 with rev counting
2026-04-27 feat: route motion commands through CAN bridge — replace disabled serial bridge calls
2026-04-27 fix: add AXIS_ALL constant to can/protocol.py
    [protocol.py]
2026-04-27 fix: attach hall interrupt after home offset set; add 100ms debounce to ISR
    [motion.cpp]
2026-04-27 fix: SPI_MODE0 for MT6816; velocity from raw encoder delta only — prevents hall-trigger jog
    [motion.cpp]
2026-04-27 fix: remove stale _prev_pos_cdeg references
    [motion.cpp]
2026-04-27 fix: use GPIO23 as dummy MOSI for SPI init — encoder SPI not initialising with MOSI=-1
    [motion.cpp]
2026-04-27 fix: restore ENC_MOSI_PIN GPIO23 — MT6816 needs MOSI connected
    [config.h, motion.cpp]
2026-04-27 fix: update LEDC API to ESP32 Arduino v3 (ledcAttach/ledcWrite by pin)
    [motion.cpp]
2026-04-27 fix: revert to ledcSetup/ledcAttachPin/channel API — ledcAttach not available in this framework version
    [motion.cpp]
2026-04-27 fix: MT6816 correct protocol — SPI_MODE3, two separate CS transactions per register, correct bit packing
    [motion.cpp]
2026-04-27 fix: MT6816 single transaction wrapping both register reads — matches working eval implementation
    [motion.cpp]
2026-04-28 fix: pass ENC_CS_PIN to SPI.begin() — ESP32 GPIO matrix requires CS registered even with manual control
    [motion.cpp]
2026-04-28 diag: replace hardware SPI with bit-bang to isolate SPI peripheral issue
    [motion.cpp]
2026-04-28 cleanup: remove encoder debug logging
2026-04-28 debug: add raw/pos serial print via motion_get_enc_raw()
2026-04-28 fix: add encoder multi-turn counter — position no longer wraps every 90° of pan
    [motion.cpp]
2026-04-28 feat: CAN status badge, auto-home on boot (5s delay), home button already wired
2026-04-28 fix: encoder parity check + sanity delta filter — reject noise-corrupted reads from motor PWM
    [motion.cpp]
2026-04-28 feat: homing sweep — drive to hall sensor trigger, set position 0 there
2026-04-28 fix: extend CAN timeout to 15s, auto-clear fault on Pi reconnect, increase auto-home delay to 10s
    [main.cpp, main.py, motion.cpp, motion.h]
2026-04-28 fix: forward-declare parity fallback variable before _enc_read_raw
    [motion.cpp]
2026-04-28 fix: unconditional fault clear on CAN reconnect; watchdog serial debug
    [main.cpp, motion.cpp]
2026-04-28 fix: watchdog uses millis() not cached now — prevents uint32 underflow false trigger
    [main.cpp]
2026-04-28 fix: increase HOME_DUTY to 150 — 50 insufficient to overcome gearbox static friction
    [config.h]
2026-04-28 cleanup: remove encoder debug serial prints
2026-04-28 fix: unify enc fallback to _enc_prev_raw; tighten sanity threshold 2000→300 counts
    [motion.cpp]
2026-04-28 fix: encoder rollover threshold 14384→16000; PWM freq 10kHz→20kHz; add sensor_monitor.py
    [config.h, motion.cpp, sensor_monitor.py]
2026-04-28 feat: position from encoder multi-turn only — hall sensor reserved for homing
2026-04-28 debug: INA226 print shunt voltage at init to diagnose zero current
2026-04-28 fix: INA226 shunt 0.1Ω→0.002Ω — common breakout board value
    [sensors.cpp]
2026-04-28 feat: velocity ramp — accel slider now controls start/stop ramp rate on brushed DC motor
2026-04-29 fix: CAN badge goes offline after 3s without frames — was never clearing on node disconnect
    [bridge.py]
2026-05-03 feat: tilt node firmware — mirrors stationary, AXIS_TILT, IMU only, no GPS
2026-05-10 fix: CAN bridge auto-reconnects after consecutive rx errors — was never recovering from bus-off
    [bridge.py]
2026-05-10 fix: CAN ENOBUFS — reconnect on consecutive send failures, not just rx errors
    [bridge.py]
2026-05-10 fix: cycle can0 interface on reconnect to flush kernel TX queue (ENOBUFS); add CAP_NET_ADMIN to service
    [bridge.py]
2026-05-10 fix: disable auto-home on boot — motor PWM was killing CAN bus 10s after every start
    [main.py]
2026-05-10 fix: TWAI bus-off auto-recovery on both nodes — was never calling twai_initiate_recovery()
    [main.cpp]
2026-05-10 fix: remove interface cycling from reconnect — ESP32 TWAI auto-recovery makes it unnecessary; removes can0 disappearing on restart
    [bridge.py]
2026-05-10 fix: don't reconnect on send errors — dropped velocity frames are harmless, reconnect from RX only
    [bridge.py]
2026-05-10 fix: reduce CAN bus load — IMU 50Hz→20Hz on both nodes, velocity commands 25Hz→10Hz
    [main.cpp]
2026-05-10 fix: TWAI recovery check 500ms→100ms — matches Pi restart-ms, prevents recovery timing deadlock
    [main.cpp]
2026-05-11 fix: guard can_send() with TWAI_STATE_RUNNING check — prevents tx_msg_count underflow crash
    [main.cpp]
2026-05-11 fix: replace twai_initiate_recovery() with full driver reinstall — eliminates tx_msg_count ISR crash
    [main.cpp]
2026-05-11 fix: skip all input elements for arrow key motion; add motor deadband compensation for stutter
    [config.h, motion.cpp]
